toulene/Lab-Kiosk-/kiosk_v2_assembly.step

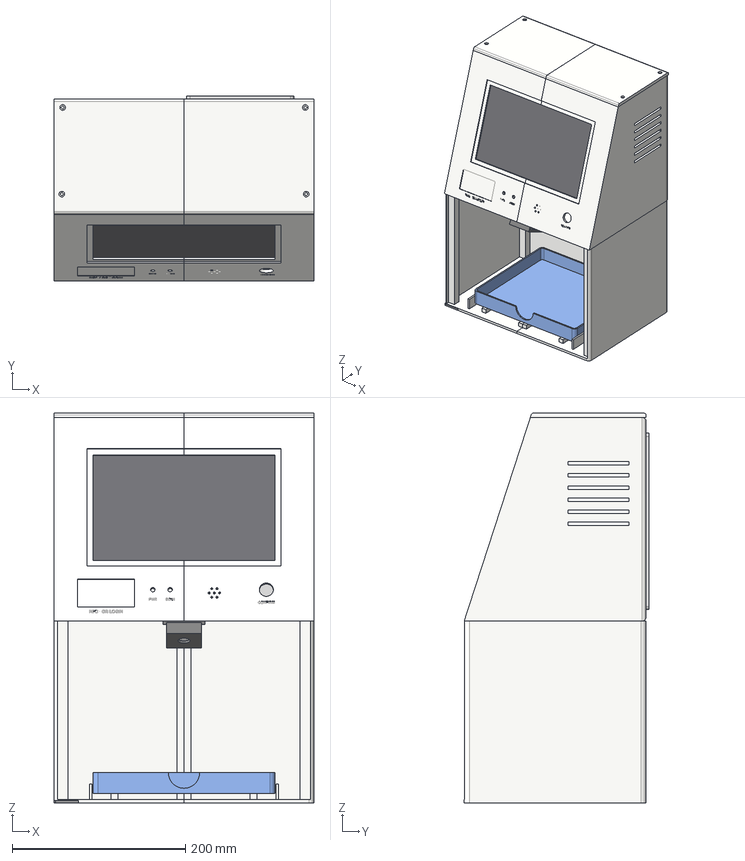
[picture p1: CAD file, 2026-10-24]
kiosk_v2_assembly.step
300.0 x 213.0 x 450.0 mm
01_base_left
02_base_right
03_head_left
04_head_right
05_roof_left
06_roof_right
07_rear_access_panel
08_component_tray
09_camera_pod
10_screen_clip_x4
REF_display_not_printed
REF_raspberry_pi5_not_printed
