toulene/Lab-Kiosk-/step/07_rear_access_panel.step

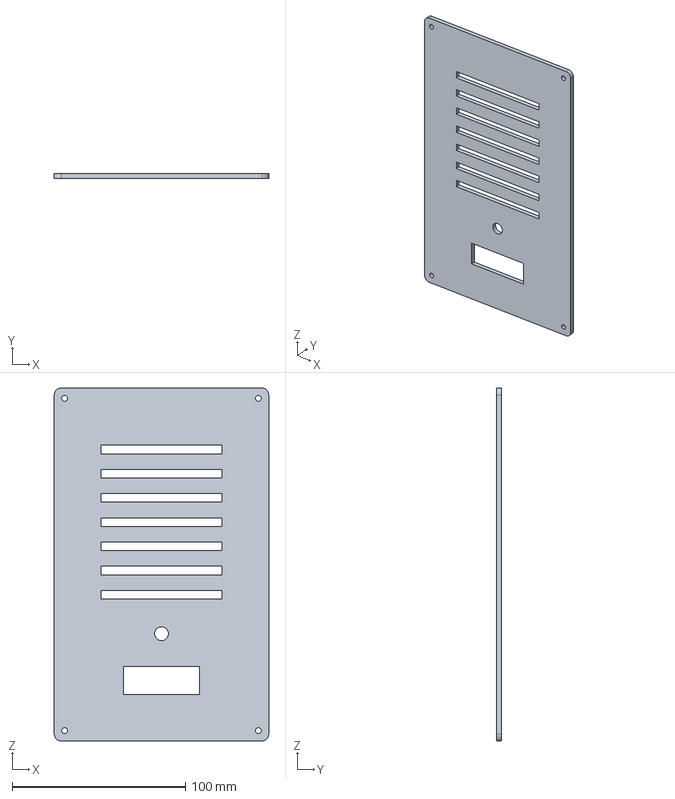
[picture p2: CAD file, 2026-10-24]
step/07_rear_access_panel.step
124.0 x 3.00 x 204.0 mm
