toulene/Lab-Kiosk-/step/09_camera_pod.step

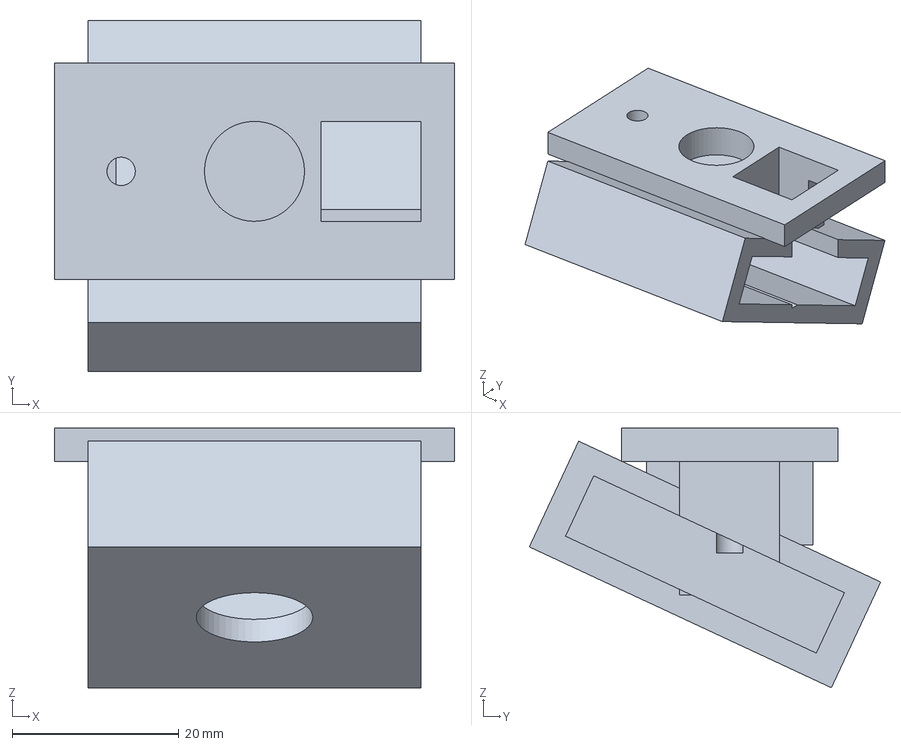
[picture p3: CAD file, 2026-10-24]
step/09_camera_pod.step
48.0 x 42.2 x 31.1 mm
