toulene/Lab-Kiosk-/step/03_head_left.step

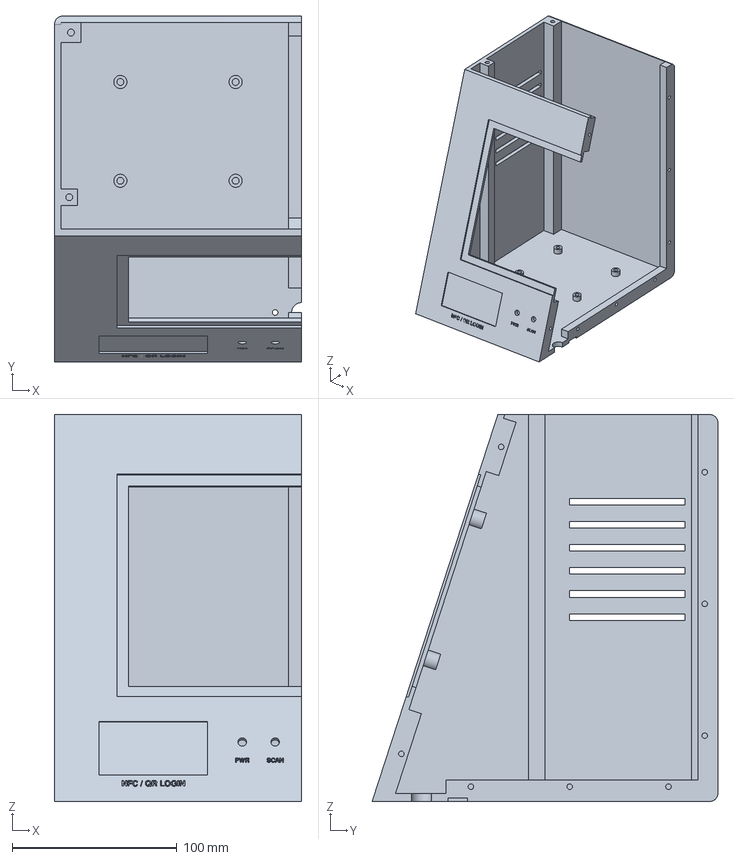
[picture p4: CAD file, 2026-10-24]
step/03_head_left.step
150.0 x 210.0 x 235.0 mm
