toulene/Lab-Kiosk-/step/10_screen_clip_x4.step

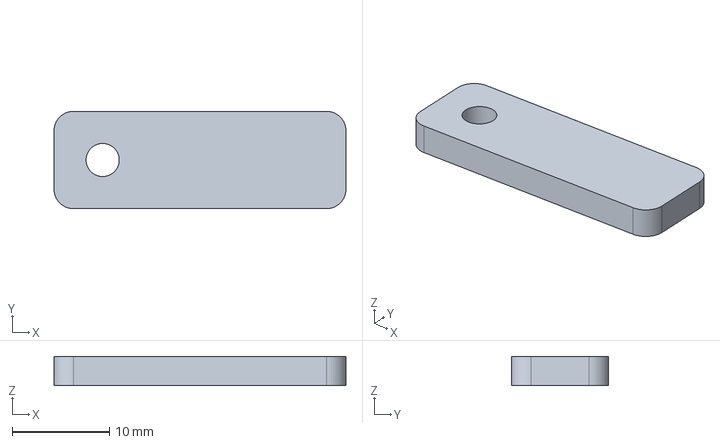
[picture p5: CAD file, 2026-10-24]
step/10_screen_clip_x4.step
30.0 x 10.0 x 3.00 mm
