toulene/Lab-Kiosk-/step/02_base_right.step

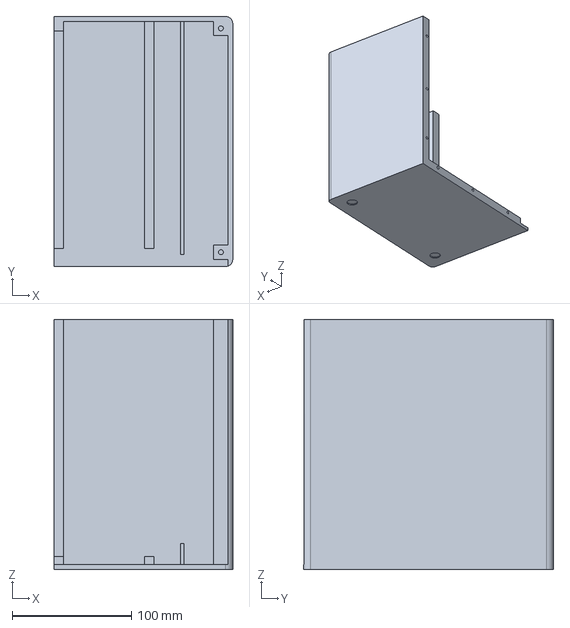
[picture p6: CAD file, 2026-10-24]
step/02_base_right.step
150.0 x 210.0 x 210.0 mm
