toulene/Lab-Kiosk-/step/06_roof_right.step

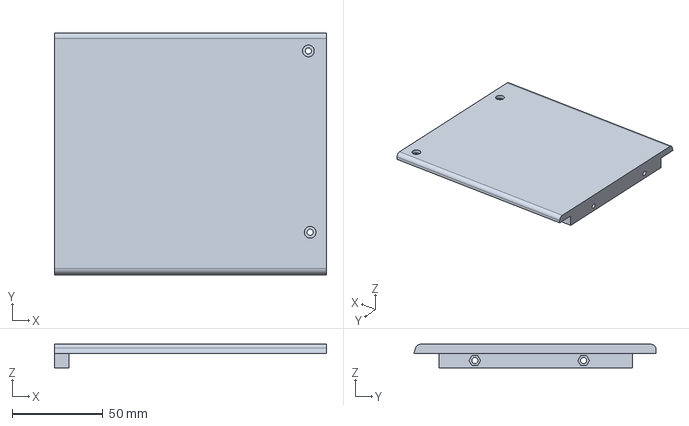
[picture p7: CAD file, 2026-10-24]
step/06_roof_right.step
150.0 x 133.6 x 13.0 mm
