toulene/Lab-Kiosk-/step/08_component_tray.step

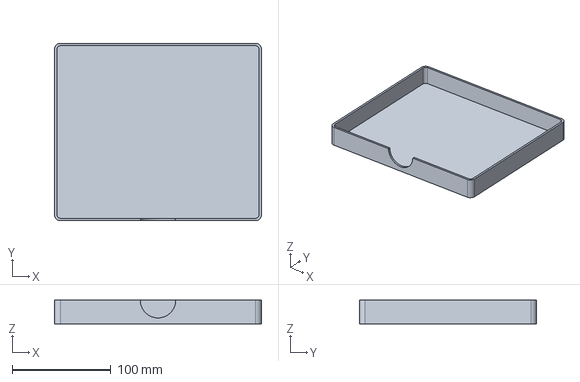
[picture p8: CAD file, 2026-10-24]
step/08_component_tray.step
210.0 x 180.0 x 24.0 mm
