toulene/Lab-Kiosk-/step/04_head_right.step

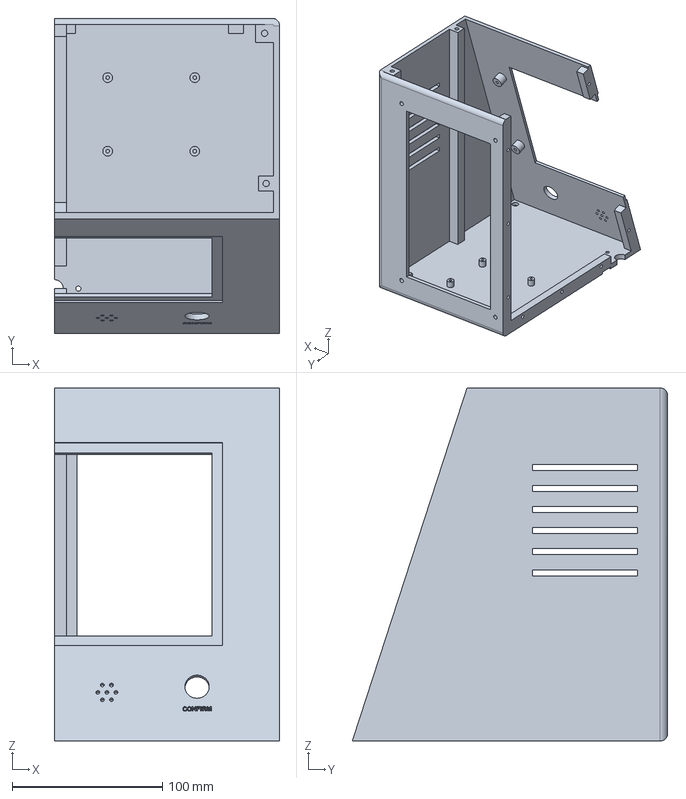
[picture p9: CAD file, 2026-10-24]
step/04_head_right.step
150.0 x 210.0 x 235.0 mm
