toulene/Lab-Kiosk-/(list of files, cad)

Other CAD files:
kiosk_v2_printable.FCStd
step/05_roof_left.step
step/01_base_left.step
stl/01_base_left.stl
stl/02_base_right.stl
stl/03_head_left.stl
stl/04_head_right.stl
stl/05_roof_left.stl
stl/06_roof_right.stl
stl/07_rear_access_panel.stl
stl/08_component_tray.stl
stl/09_camera_pod.stl
stl/10_screen_clip_x4.stl
