toulene/Lab-Kiosk-/(commit log)

2026-10-24 Lab kiosk: kiosk app, prototype, dataset pipeline and enclosure
    - prototype/: Pi tray scanner (camera -> labeller -> admin site) with Roboflow,
    Groq and Gemini labellers, Pi setup script and laptop admin website
    - images/kiosk_app/: full kiosk app with offline ONNX detector; no built-in
    admin PIN (KIOSK_ADMIN_PIN, or a random one generated on first start)
    - images/: frame extraction, auto-labelling, dataset merge (13 public
    Roboflow datasets + own frames), local RF-DETR training and testing
    - CadQuery enclosure source with STEP/STL exports
    Datasets, frames, weights and API keys are kept out of git.
    [01_base_left.step, 01_base_left.stl, 02_base_right.step, 02_base_right.stl, 03_head_left.step, 03_head_left.stl, 04_head_right.step, 04_head_right.stl]
2026-10-24 Revise README for project name and details
    Updated project name and clarified Raspberry Pi model in README.
